sv-enkidu/esp-32-signalk-boatData-puck/IMG_5853.jpeg

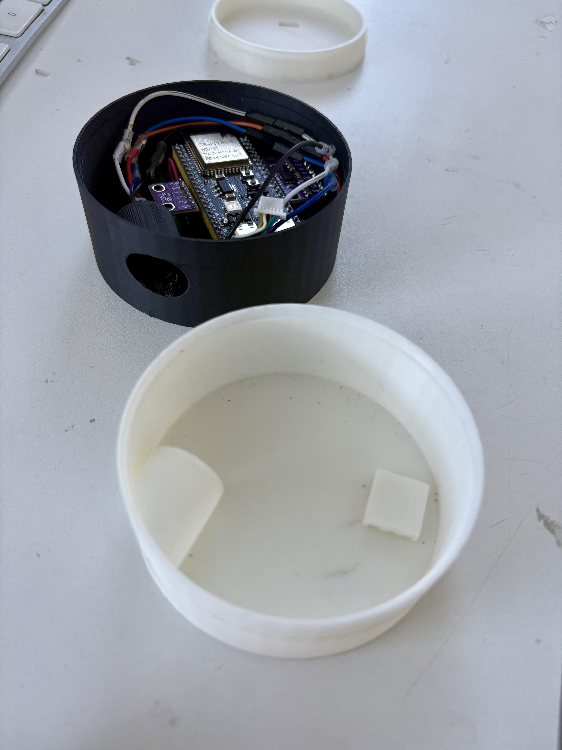
IMG_5853.jpeg
