sv-enkidu/esp-32-signalk-boatData-puck/offset_helper_plot_example.png

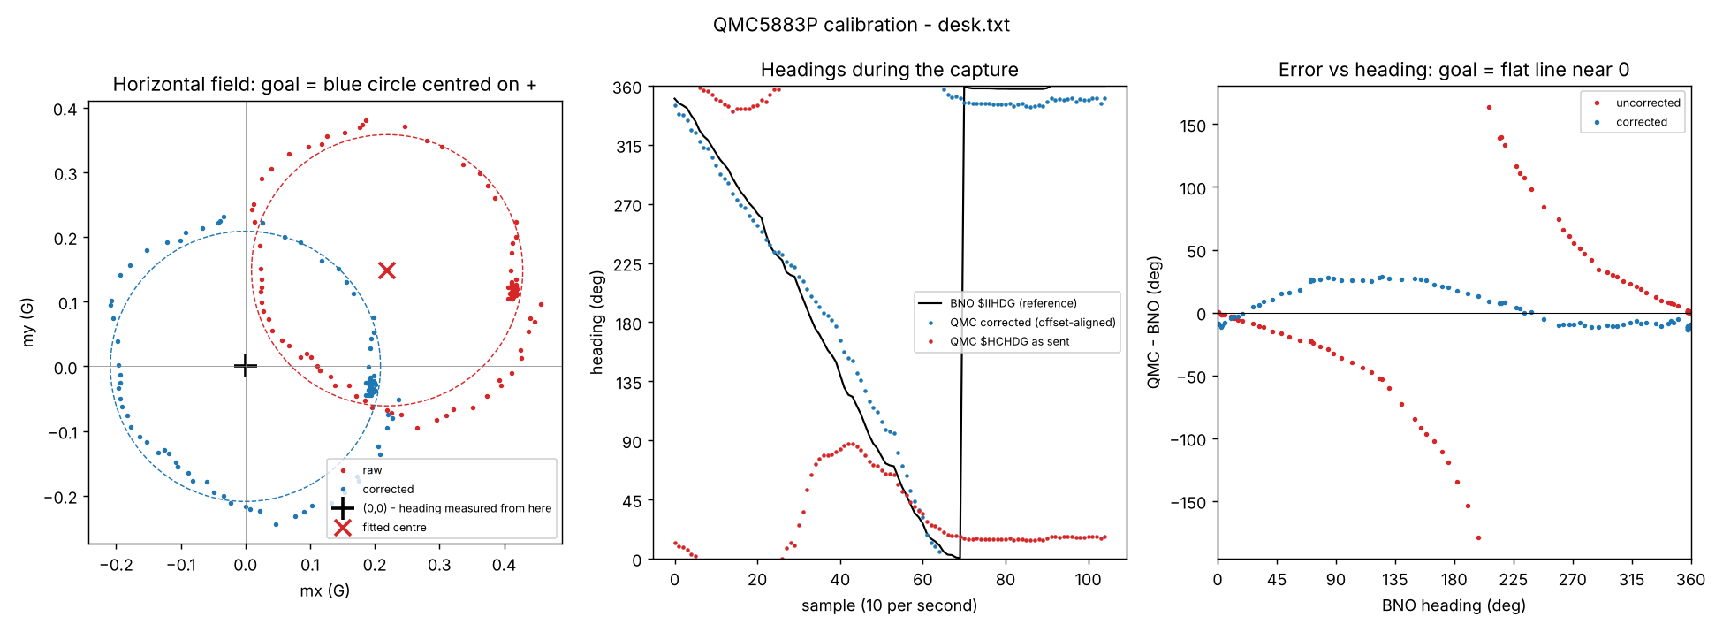
offset_helper_plot_example.png
