sv-enkidu/esp-32-signalk-boatData-puck/puck_case_pcb3.stl

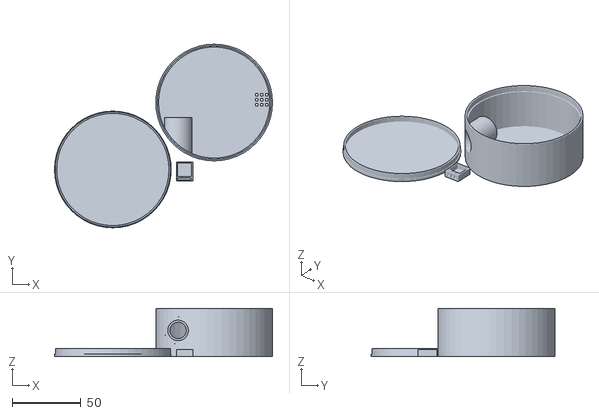
[picture p3: CAD file, 2026-10-16]
puck_case_pcb3.stl
158.8 x 133.8 x 35.0
