sv-enkidu/esp-32-signalk-boatData-puck/(commit log)

2026-05-30 Initial release: ESP32 multi-sensor boat puck firmware
    NMEA0183 and Signal K JSON versions for GPS, QMC5883P compass,
    BNO085 IMU, and BME680 environmental sensor on ESP32-S3.
2026-06-14 Add v2.2 sketch and BNO08x IMU README
2026-08-24 Add files via upload
    Latest boat puck with BME280 sensor and UART connected IMU
2026-10-16 Add files via upload
    Puck enclosure example 3D print file
2026-10-19 Add files via upload
    Includes advanced compass offset/calibration
